nakayama-software/ciren/images/sensor_controller.png

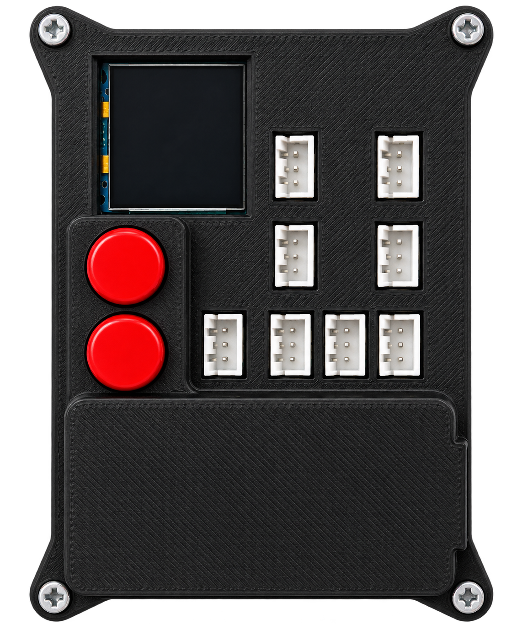
images/sensor_controller.png
