nakayama-software/ciren/frontend/src/assets/forklift.png

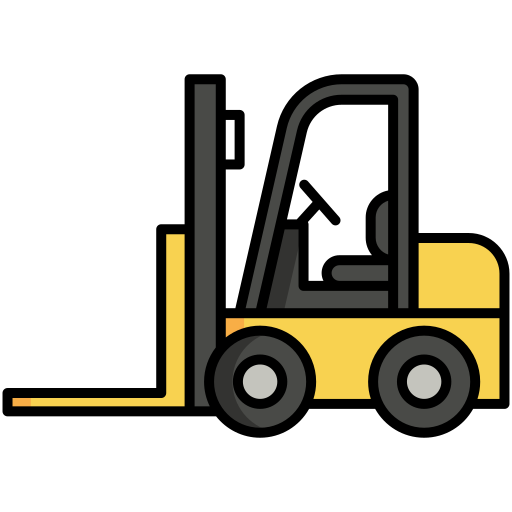
frontend/src/assets/forklift.png
