nakayama-software/ciren/images/summary_data_table_jp.png

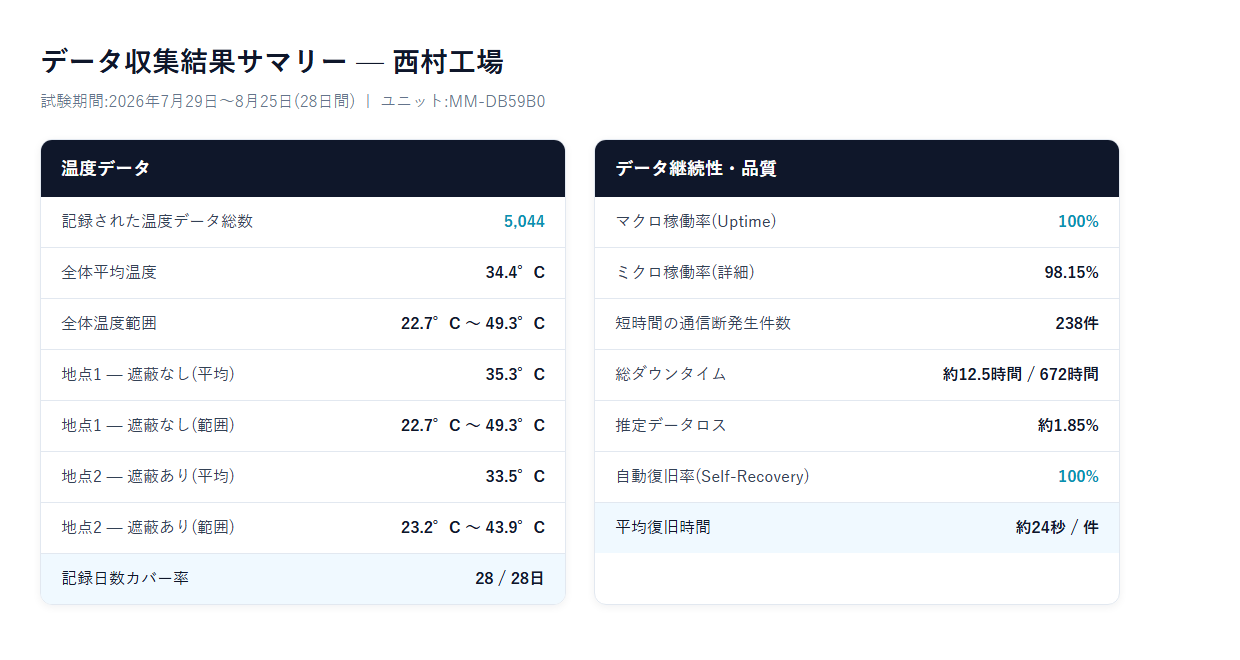
images/summary_data_table_jp.png
