nakayama-software/ciren/CIREN_DOCUMENT/CIREN_MANUAL_BOOK.docx

CIREN

Real-Time IoT Monitoring System

MANUAL BOOK

Version: 1.0

Date: 2026-05-29

Audience: Operators & Daily Users

DOCUMENT CONVENTIONS

[NOTE] | General information worth paying attention to
[TIP] | Helpful suggestion to get the most out of the system
[WARNING] | Action that may cause data loss or system disruption
[REQUIRED] | Step that must not be skipped

CHAPTER 1 — INTRODUCTION

1.1 About This Manual

This manual is the primary operational guide for CIREN. It covers everything you need to install the hardware, access the dashboard, monitor sensor data, configure alerts, export reports, and keep the system running.

This manual is written for operators and daily users. No programming or networking experience is required to follow it.

[NOTE] | For advanced technical details (firmware, protocol, API), refer to the CIREN System Specification document.

1.2 What is CIREN

CIREN is a plug-and-play real-time IoT (Internet of Things) monitoring system. It reads data from physical sensors, transmits that data wirelessly to the cloud, and displays it live on a web-based dashboard — accessible from any browser, anywhere.

Key benefits:

- No complex installation — hardware self-configures on first power-on
- No dedicated IT team needed — designed for non-technical users
- Works even without stable WiFi — built-in LTE-M cellular fallback
- Expandable — add more sensors or locations without replacing hardware

1.3 System Components at a Glance

Component | Description
Sensor Node | Small device with one sensor attached. Plugs into the Sensor Controller via cable.
Sensor Controller | Collects data from up to 8 Sensor Nodes. Sends data wirelessly to the Main Module.
Main Module | The central gateway. Receives data from all controllers and sends it to the cloud via WiFi or LTE-M (cellular) backup.
Dashboard | Web-based control panel. View live readings, set alerts, export data, configure sensors.

1.4 Document Conventions

- Steps are numbered: 1. 2. 3. ...
- Sub-steps are lettered: a. b. c. ...
- File paths and technical values are written in: [square brackets]
- Screen elements (buttons, menus) are written in: "quotes"

CHAPTER 2 — BEFORE YOU START

2.1 What's in the Package

Standard Starter Kit contents:

Qty | Item
1 | Main Module (ESP32-S3 + SIM7080G + TFT display)
1 | Sensor Controller (ESP32)
2 | Sensor Nodes (type depends on order)
2 | UART connection cables (sensor node ↔ controller)
1 | Power supply — Main Module
1 | Power supply — Sensor Controller

[NOTE] | Additional sensor nodes and controllers can be added at any time without replacing existing hardware.

2.2 Requirements

To access the dashboard:

- A modern web browser (Chrome, Firefox, or Edge — latest version)
- Internet access or access to the local network where CIREN is hosted
- A CIREN user account (provided by your system administrator)

To run the hardware:

- Stable power supply for each unit (see power specs in Appendix A)
- WiFi network with internet access, OR a SIM card with LTE-M data plan
- Physical mounting location within sensor range of the controller

2.3 Safety Notes

[WARNING] | Always power off the Main Module before inserting or removing the SIM card. Hot-plugging the SIM can damage the modem.

[WARNING] | Do not expose hardware to rain, condensation, or liquids unless housed in a weatherproof enclosure.

[NOTE] | Operating temperature range: -40°C to +80°C. DHT20 sensor accuracy may degrade above +80°C.

[NOTE] | Use a stable, regulated power supply. Power fluctuations can cause unexpected resets. The system has a built-in hardware watchdog that will auto-restart after a crash (~3 minutes).

CHAPTER 3 — HARDWARE INSTALLATION

Install and commission hardware in this order:

3.1 Power On Main Module | 3.2 Configure WiFi | 3.3 SIM Card & APN | 3.4 Verify Online | 3.5 Power On Controller | 3.6 Verify Controller | 3.7 Connect Sensor Nodes

[NOTE] | Always set up the Main Module and confirm cloud connectivity before adding Sensor Controllers or Nodes. This makes each step verifiable as you go.

3.1 Step 1 — Power On the Main Module

The Main Module is the central gateway. Set it up first.

1. Place the Main Module in its final mounting location.
2. Connect the power supply.
3. The TFT display powers on and shows the boot screen (Device ID, firmware version).
4. Wait ~10 seconds for the module to complete startup.
5. Check the TFT display — it shows one of: "hotspot mode" (go to 3.2), conn mode = "wifi" (go to 3.4), or conn mode = "offline" (go to 3.2).

[NOTE] | The Main Module does not require any sensor hardware to be connected at this stage. It can come online independently.

3.2 Step 2 — Configure WiFi

On first power-on (or after a WiFi reset), the Main Module enters hotspot mode automatically.

6. On your phone or PC, open WiFi settings.
7. Connect to the temporary hotspot created by the Main Module. (Name and password are on the device label.)
8. A configuration page opens automatically. If not, navigate to: [192.168.4.1]
9. Enter your WiFi network name (SSID) and password.
10. Click "Save" or "Connect".
11. The Main Module reboots and connects to your WiFi.
12. TFT display changes to: conn mode = "wifi".

[NOTE] | If setup fails (wrong password, out of range), the module retries. Power cycle to re-enter hotspot mode.

[TIP] | If the facility has a dedicated IoT VLAN, use that network for better isolation.

[TIP] | If you will rely entirely on LTE-M (no WiFi), skip this step and proceed directly to Step 3.

3.3 Step 3 — Insert SIM Card & Configure APN (Optional — LTE-M Fallback)

The SIM card enables automatic connectivity when WiFi is unavailable. Configure APN settings before verifying connectivity, so both connection paths are ready.

[REQUIRED] | Power off the Main Module completely before inserting the SIM card.

A. Insert SIM Card

13. Power off the Main Module and disconnect power.
14. Locate the SIM card slot on the SIM7080G modem (side of the Main Module enclosure).
15. Insert a nano SIM card with an active LTE-M (Cat-M1) data plan. Recommended: Soracom Air plan-D (~¥330/month, includes 300MB). Any LTE-M compatible SIM will work.
16. Reconnect power and power on the Main Module.

B. Configure APN Settings

17. Connect to the Main Module hotspot (or existing WiFi) and open the config page at: [192.168.4.1]
18. Navigate to the "SIM / Cellular" settings section.
19. Enter the APN details for your SIM provider (see table below).
20. Click "Save". The module reboots.
21. The module tries WiFi first. If WiFi is unavailable, it switches to LTE-M automatically. TFT shows: conn mode = "sim".

Provider | APN | Username | Password
Soracom Air | soracom.io | sora | sora
IIJmio (LTE-M) | iijmio.jp | mio@iij | iij
Other providers | (see SIM provider documentation) | — | —

[NOTE] | CIREN sensor data is very lightweight (well under 300MB/month even with many sensors at high update rates).

[TIP] | Even if WiFi is available, installing a SIM card is recommended as insurance against network outages.

[NOTE] | If the APN is incorrect, the modem will fail to register on the network. The TFT will show conn mode = "sim" but the device will appear offline on the dashboard. Double-check APN with your SIM provider if this occurs.

3.4 Step 4 — Verify Main Module is Online

Confirm the Main Module is connected and visible on the dashboard before adding any Sensor Controllers.

22. Open the CIREN dashboard in a browser.
23. Log in with your account credentials.
24. The device should appear in the Device List within ~30 seconds.
25. The status indicator should show "Online".
26. Check the connection mode badge — "WiFi" or "LTE-M".

[NOTE] | If the device does not appear after 60 seconds, refer to Chapter 10 — Troubleshooting, Section 10.1.

[REQUIRED] | Do not proceed to Step 5 until the Main Module shows "Online" on the dashboard.

3.5 Step 5 — Power On the Sensor Controller

Once the Main Module is confirmed online, power on the Sensor Controller.

27. Place the Sensor Controller within wireless range of the Main Module. Recommended: within 30–50 meters in industrial environments. Walls and metal reduce range significantly.
28. Connect the Sensor Controller to its power supply (3.3V regulated / USB).
29. The controller starts automatically — no buttons to press.
30. It begins scanning for the Main Module via ESP-NOW (2.4 GHz).

[NOTE] | At this stage, sensor nodes do not need to be connected yet. The controller will pair with the Main Module first.

[TIP] | During initial setup, place the Sensor Controller physically close to the Main Module to ensure reliable first pairing. It can be moved to its final location after pairing is confirmed.

3.6 Step 6 — Verify Sensor Controller Detected

Confirm the Sensor Controller is paired with the Main Module before connecting any Sensor Nodes.

On the TFT display (Main Module):

31. Wait for Page 4 — Controller List to appear (display cycles automatically).
32. Confirm the controller's MAC address or ID appears in the list.
33. The "last received" timestamp should be updating within the last few seconds.

On the Dashboard:

34. Open Device Detail for the Main Module device.
35. A new Sensor Controller card should appear.
36. All 8 port slots will show as empty/inactive — this is expected.

[NOTE] | If the controller does not appear within ~30 seconds, check distance and obstacles. Move closer and power cycle the controller.

[REQUIRED] | Do not connect Sensor Nodes until the controller is visible on the dashboard.

3.7 Step 7 — Connect & Verify Sensor Nodes

Connect Sensor Nodes one at a time and verify each one before continuing. This makes troubleshooting easier if a node has a problem.

For each Sensor Node:

37. Identify the target port number on the Sensor Controller (labeled 1–8).
38. Connect the Sensor Node cable to the port. Match wire colors: VCC (red) → VCC, GND (black) → GND, TX → RX, RX → TX.
39. Secure the cable connector firmly.
40. Wait ~5–10 seconds.
41. On the dashboard (Device Detail), the corresponding port card should become active and show: sensor type (auto-detected) and a live reading value.
42. Confirm the reading looks reasonable for the sensor type and location.
43. Assign a label to the port (see Section 6.1). E.g., "Port 1 — Cold Room East".
44. Repeat for each remaining Sensor Node.

[NOTE] | Maximum cable length between node and controller: ~10 meters. Use shorter cables where possible.

[NOTE] | Sensor type is detected automatically. No manual type selection is needed.

[TIP] | Label each port immediately at installation, before moving to the next node. Labels carry through to exported data files.

[WARNING] | If a port does not activate within 30 seconds, check the cable connection and wire color matching. Do not proceed to the next node until the current one is confirmed active.

CHAPTER 4 — DASHBOARD ORIENTATION

4.1 Logging In

45. Open your browser and navigate to the CIREN dashboard URL. (Provided by your system administrator.)
46. Enter your username and password.
47. Click "Login".

[NOTE] | If you forget your password, contact your system administrator. There is no self-service password reset.

4.2 Dashboard Layout Overview

Level | Name | Description
Level 1 | Device List | The home page. Shows all devices registered to your account. Each card displays device name/ID, Online/Offline status, connection mode, and last seen timestamp.
Level 2 | Device Detail | Opened by clicking a device. Shows all Sensor Controllers connected to that device. Each controller lists its sensor ports (1–8) as cards.
Level 3 | Sensor Card | Each port shows a Sensor Card with: current live reading, port label, upload interval badge, and threshold alert indicator.

4.3 Device List Page

What you see:

- All registered devices in a list or grid
- Green dot = Online | Grey dot = Offline
- "WiFi" or "LTE-M" badge showing active connection type
- Last seen time (e.g., "2 seconds ago" or "Last seen: 14:32:05")

Actions available:

- Click a device → opens Device Detail
- The list updates automatically in real time via WebSocket

4.4 Device Detail Page

What you see:

- All Sensor Controllers linked to this device
- Each controller shows 8 port slots (occupied or empty)
- Each occupied port shows a Sensor Card with live data

[NOTE] | Empty ports (no sensor connected) show as inactive/greyed out. They become active automatically when a sensor node is plugged in.

4.5 Sensor Card Explained

Element | Description
Port Label | Custom name you assign (e.g., "Cold Room 1"). Default: "Port 1", "Port 2", etc.
Interval Badge | Upload frequency (e.g., "500ms"). Click to change.
Live Reading | The most recent sensor value with its unit.
Sensor Type | Detected automatically (e.g., "Temperature", "Vibration").
Threshold Indicator | Shows a warning if the value is out of your set range.

4.6 Status Indicators

Indicator | Meaning
● Green (device) | Online — data being received in real time
● Grey (device) | Offline — no data received recently
[WiFi] | Main Module connected via your local WiFi network
[LTE-M] | Main Module connected via SIM cellular (WiFi unavailable)
[500ms] badge | Sensor uploads a new reading every 500 milliseconds
[Pending] badge | A new interval was set but not yet received by the controller
[Delivered] badge | Interval configuration confirmed by the controller

[NOTE] | When a device goes offline, the last known sensor values remain visible on all Sensor Cards. A timestamp shows when data was last received.

CHAPTER 5 — DAILY OPERATIONS

5.1 Monitoring Live Sensor Data

Live data updates automatically — you do not need to refresh the browser.

48. Log in to the dashboard.
49. Click a device from the Device List.
50. View the Sensor Cards on the Device Detail page.
51. Each card updates its reading in real time as new data arrives.

[TIP] | Keep the dashboard open on a dedicated monitor at your workstation or control room for continuous visibility.

5.2 What the Readings Mean

Sensor / Reading | Unit | Notes
Temperature | °C | Ambient air temperature. Normal room: ~18°C–25°C. Cold storage: 0°C–8°C.
Humidity | % RH | Relative Humidity. Comfortable indoor: 40%–60% RH. 100% = condensation risk.
Acceleration X/Y/Z | m/s² | Vibration and movement. Near-zero = at rest. Spikes = abnormal vibration.
Gyroscope X/Y/Z | °/s | Rotational speed. Useful for detecting tilt, rotation, or angular movement.
Pitch / Roll / Yaw | ° | Euler angles from IMU. Pitch = forward/backward. Roll = left/right. Yaw = rotation.

5.3 Checking Device Connection Status

52. On the Device List page, check the status indicator for each device.
53. If a device shows "Offline", check the Main Module at the physical site: Is it powered on? What does the TFT display show? Is WiFi available or the SIM card active?
54. Refer to Chapter 10 — Troubleshooting for specific scenarios.

5.4 Offline Device — What to Expect

When a device loses connection:

- The device status changes to "Offline" on the Device List.
- All Sensor Cards continue to display the last known values.
- A "Last seen" timestamp shows when data was last received.
- Data is NOT lost — readings taken while offline are stored in the device's local buffer and re-published when connection is restored.

[NOTE] | If the device has been offline for an extended period, the last-seen values may be significantly outdated. Check the timestamp before acting on the displayed reading.

CHAPTER 6 — SENSOR CONFIGURATION

6.1 Assigning Labels to Sensor Ports

Labels make it easy to identify sensors on the dashboard and in exports. Example: rename "Port 3" to "Freezer Room — East Wall".

55. Open the Device Detail page and find the Sensor Card you want to label.
56. Click the label / edit icon next to the current port name.
57. Type a descriptive name.
58. Click "Save".
59. The new label appears on the card and in all exported data files.

[TIP] | Use location + measurement: e.g., "Motor A — Vibration"

6.2 Setting Upload Intervals

The upload interval controls how often a sensor node sends a new reading. A shorter interval = more frequent data = higher data usage.

Sensor Type | Default Interval | Recommended Minimum
Temperature / Humidity | 500ms (2 readings/sec) | 500ms
IMU / Vibration | 200ms (5 readings/sec) | 200ms

Steps to change the interval:

60. Click the interval badge on the Sensor Card (e.g., "[500ms]").
61. A dialog opens — enter the new interval in milliseconds. Example: 1000 = 1 second, 5000 = 5 seconds, 60000 = 1 minute.
62. Click "Save".
63. The badge changes to "[Pending]" while the setting is being delivered.
64. When the controller confirms receipt, it changes to "[Delivered]".

[NOTE] | The interval is saved on the controller's non-volatile memory. It is retained after a power cut and does not need to be re-entered after a reboot.

[TIP] | For non-critical monitoring (e.g., room temperature), set a longer interval (5000ms–60000ms) to reduce data usage and storage.

6.3 Hot-Swapping a Sensor Node

CIREN supports hot-swapping — you can replace a sensor node on a port without restarting the system.

65. Unplug the sensor node cable from the controller port.
66. Plug in the new sensor node to the same port.
67. The controller detects the new sensor type automatically within ~5 seconds.
68. The Sensor Card on the dashboard updates to show the new sensor type and reading.

[NOTE] | When a sensor type changes on a port, the upload interval resets to the default for the new sensor type. Re-configure the interval if needed (see Section 6.2).

[WARNING] | Do not hot-swap while the controller is transmitting a config update (interval badge shows "Pending"). Wait for "Delivered" or "Failed" before swapping.

CHAPTER 7 — ALERTS & THRESHOLDS

7.1 Setting a Threshold

Thresholds define acceptable value ranges for a sensor. The dashboard shows a visual alert when a reading falls outside the range.

69. Open the Sensor Card for the target sensor.
70. Click the threshold icon or button (bell / alert icon).
71. A dialog opens with two fields: Minimum (alert if value falls BELOW this) and Maximum (alert if value rises ABOVE this). You can set one or both.
72. Click "Save".

Example — Cold Room temperature:

- Minimum: 0°C (alert if it drops below freezing)
- Maximum: 8°C (alert if it rises too high)

7.2 Understanding Threshold Alerts

When a sensor reading crosses a threshold:

- The Sensor Card shows a visual warning indicator (color change / icon).
- The alert is visible in real time as long as the browser is open.

[NOTE] | CIREN dashboard alerts are visual only (on-screen). There is no email or SMS notification in the current version. Keep the dashboard open on a monitor for continuous alerting.

[TIP] | For attended monitoring environments, assign a team member to watch the dashboard during critical operating hours.

7.3 Editing or Removing a Threshold

To edit:

73. Click the threshold icon on the Sensor Card.
74. Change the minimum and/or maximum values.
75. Click "Save".

To remove:

76. Click the threshold icon on the Sensor Card.
77. Clear both the minimum and maximum fields.
78. Click "Save".
79. The threshold alert is removed from that sensor card.

CHAPTER 8 — HISTORICAL DATA & EXPORT

8.1 Viewing Sensor History Chart

80. Open the Sensor Card for the target sensor.
81. Click the "History" button or chart icon.
82. A modal opens with a line chart of historical readings.
83. The chart loads automatically for a default time range (e.g., last hour).
84. Use the time range selector to zoom in or out (see Section 8.2).

8.2 Filtering by Time Range

In the History modal:

85. Use the time range controls to set a "From" and "To" date/time.
86. Click "Apply" or "Load" to refresh the chart.

[NOTE] | Historical data is stored for 30 days. Readings older than 30 days are automatically deleted.

[TIP] | For compliance reporting, export data regularly (see Section 8.3) rather than relying on the 30-day retention window.

8.3 Exporting Data (CSV / JSON)

Export sensor readings to a file on your computer for reporting, archiving, or further analysis in Excel or other tools.

87. Open the Sensor Card and click "History" or the "Export" button.
88. In the export dialog, select: Format (CSV or JSON), Device, Sensor, From date/time, To date/time.
89. Click "Download".
90. The file downloads to your computer automatically.

[TIP] | CSV format is recommended for most users. Open it directly in Microsoft Excel or Google Sheets for charts and analysis.

8.4 Using Exported Data

CSV file structure:

timestamp, device_id, ctrl_id, port_num, sensor_type, value

Example row:

2026-05-29T08:32:15.000Z, ciren-001, 1, 3, temperature, 22.4

[TIP] | In Excel, use "Insert Chart" with the timestamp and value columns to create a visual trend chart for reports.

CHAPTER 9 — MAINTENANCE

9.1 Routine Checks (Recommended: Weekly)

Hardware:

☐ All sensor node cables are firmly connected to the controller

☐ All units have stable power (check power LEDs)

☐ Main Module TFT display shows correct conn mode (wifi/sim)

☐ Main Module is online on the dashboard

Dashboard:

☐ All expected devices show "Online" status

☐ Sensor readings are updating in real time (not frozen)

☐ No unexpected threshold alerts are active

9.2 Hardware Care & Placement Tips

Main Module:

- Mount in a dry, ventilated location — avoid direct sunlight
- Keep away from strong electromagnetic sources (motors, inverters)
- Ensure WiFi antenna has clear line of sight to the router

Sensor Controller:

- Mount within 30–50m of the Main Module in industrial environments
- Avoid placing behind thick concrete walls or large metal structures
- Keep ventilated — operating temperature up to +85°C

Sensor Nodes:

- Mount sensors in the location being measured, not the controller
- DHT20 (temperature/humidity): avoid condensing environments; allow airflow around the sensor
- MPU6050 (vibration): mount firmly on the surface being measured; loose mounting causes noise

Cables:

- Secure UART cables to prevent vibration-induced disconnection
- Maximum cable length: ~10 meters (shorter is better)
- Avoid routing cables near high-voltage power lines

9.3 Updating WiFi Credentials

If your WiFi network name or password changes:

91. Power cycle the Main Module (turn off, wait 5 seconds, turn on).
92. While powered off, hold the [WiFi Reset] button for 3 seconds to clear stored credentials and re-enter hotspot mode.
93. The TFT display shows the module is in hotspot/setup mode.
94. Follow the WiFi setup steps in Section 3.2.

9.4 SIM Card Management

Checking data usage:

- Log in to your SIM provider's portal (e.g., Soracom console).
- CIREN typically uses well under 300MB/month per device.

Replacing a SIM card:

95. Power off the Main Module completely.
96. Remove the old SIM and insert the new one.
97. Power on — the modem registers to the new SIM automatically.

If LTE-M stops working:

- Check SIM card is seated correctly (remove and re-insert)
- Confirm data plan is still active (check provider portal)
- Confirm LTE-M coverage at your location (check carrier coverage map)

CHAPTER 10 — TROUBLESHOOTING

10.1 Device Shows Offline on Dashboard

Symptoms: Device status = grey "Offline", last seen time is old.

Check | Action
a) Main Module powered on? | Check power LED. If off: check power cable and supply.
b) TFT display reading? | "wifi" = connected to WiFi but not server — check internet. "sim" = LTE-M active — check SIM plan. Blank/error = check power supply.
c) WiFi credentials changed? | Re-configure WiFi (see Section 9.3).
d) Server running? | Contact your system administrator.
e) Hardware watchdog? | Module auto-restarts within ~3 minutes after a crash. Wait and check again before taking further action.

10.2 No Sensor Data on a Port

Symptoms: Sensor Card on dashboard shows no reading or is inactive.

Check | Action
a) Cable plugged into correct port? | Verify the physical connection at the controller.
b) Sensor node powered? | Check sensor node power LED. Try disconnecting and reconnecting the cable.
c) Controller detecting the sensor? | Auto-detection takes up to 10 seconds after plug-in.
d) Controller in range? | Move closer or remove obstructions. Keep within 30–50m in industrial environments.
e) Recently hot-swapped? | Sensor type resets on swap — wait for auto-detection.

10.3 Upload Interval Stuck on "Pending"

Symptoms: Interval badge shows "Pending" for more than 2 minutes.

Check | Action
a) Controller online? | If the device itself is offline, resolve that first (see 10.1).
b) Controller rebooted? | Config is automatically re-sent within ~10 seconds of reboot. Wait briefly and check again.
c) Re-send manually? | Open the interval setting dialog again, re-enter the value, and click Save to re-trigger delivery.

10.4 Data Export Returns Empty

Symptoms: Exported file has no rows (CSV) or empty array (JSON).

Check | Action
a) Time range correct? | Open the History chart for the same sensor and time range. If chart is also empty, no data exists for that period.
b) Correct device/sensor? | Confirm the correct device ID and port number are selected in the export dialog.
c) Data retention limit? | Data older than 30 days is automatically deleted. Older data must have been exported previously.

10.5 Main Module Won't Connect to WiFi

Cause | Fix
Wrong password | Re-enter WiFi credentials (see Section 9.3).
Network out of range | Move the Main Module closer to the router, or use a WiFi repeater/extender.
Network uses 5 GHz only | CIREN supports 2.4 GHz only. Ensure your router has a 2.4 GHz band enabled.
Captive portal network | CIREN cannot authenticate through captive portals. Use a standard password-protected WiFi network.
WiFi cannot be resolved | Insert a SIM card and use LTE-M as the primary connection (see Section 3.3).

10.6 When to Contact Support

Contact your system administrator or CIREN support if:

- The Main Module TFT display shows a persistent error code
- A device has been offline for more than 24 hours with no clear cause
- Sensor readings appear incorrect or unrealistic after checking cables
- You need to add new sensor nodes, controllers, or devices
- You need a new user account or password reset

When contacting support, have the following ready:

- Device ID (shown on the dashboard and on the Main Module label)
- Description of the problem and when it started
- What you have already tried (from the steps above)
- Any error messages or codes shown on the TFT display

APPENDIX A — SENSOR QUICK REFERENCE

DHT20 — Temperature & Humidity

Measurement | Range | Accuracy | Default Interval
Temperature | -40°C to +80°C | ±0.5°C | 500ms
Humidity (RH) | 0% to 100% RH | ±3% RH | 500ms

[NOTE] | Avoid condensing environments for long-term accuracy.

MPU6050 — Vibration / IMU (Accelerometer + Gyroscope)

Measurement | Range | Unit | Default Interval
Acceleration | ±2g to ±16g | m/s² | 200ms
Gyroscope | ±250 to ±2000°/s | °/s | 200ms
Pitch/Roll/Yaw | 0° to 360° | ° | 200ms

[NOTE] | Mount firmly on the surface being measured. Avoid strong magnetic fields.

APPENDIX B — MAIN MODULE TFT DISPLAY PAGES

The Main Module has a 2.4" TFT display that cycles through 6 status pages.

Page | Name | Information Shown
1 | Identity | Device ID, firmware version, uptime
2 | Connectivity | conn mode (wifi / sim / offline), IP address or signal strength
3 | MQTT Status | Connection state, broker address, last publish timestamp
4 | Controller List | Number of active controllers, last received data from each
5 | System Health | Free heap memory, CPU load, watchdog status
6 | SIM / Cellular Status | Carrier name, signal quality, data session status (shown only if SIM inserted)

APPENDIX C — GLOSSARY

Term | Meaning
APN | Access Point Name — the network address setting required by a SIM card to connect to the mobile data network.
Dashboard | The web-based control panel for CIREN, accessible from any browser.
Device | A complete CIREN installation at one location, identified by a unique Device ID.
ESP-NOW | The short-range wireless protocol used internally between Sensor Controllers and the Main Module. No internet required — works like local radio.
Euler Angles | Pitch, Roll, and Yaw — three angles that describe the orientation of an object in 3D space.
Firmware | The embedded software running inside the hardware components (not user-editable in normal operation).
Hot-swap | Replacing a sensor node while the system is running, without powering off or restarting.
IMU | Inertial Measurement Unit — a sensor that measures acceleration and rotation. Used for vibration monitoring and orientation tracking.
LTE-M / Cat-M1 | A low-power cellular standard for IoT devices. Works on mobile networks (requires a SIM card).
Main Module | The central gateway device. Receives data from all Sensor Controllers and sends it to the cloud.
MQTT | The lightweight messaging protocol used by CIREN to send sensor data to the cloud backend.
NVS | Non-Volatile Storage — memory that retains data after a power cut (used to store interval configs).
Relative Humidity | % RH — the amount of moisture in the air relative to the maximum it can hold at that temperature. 0% = dry, 100% = saturated.
Sensor Controller | The device that collects data from up to 8 Sensor Nodes and forwards it wirelessly to the Main Module.
Sensor Node | The smallest unit in the system. One sensor per node. Plugs into the Sensor Controller via cable.
Threshold | A user-defined min/max range for a sensor. The dashboard alerts visually when the range is exceeded.
Upload Interval | How often a Sensor Node sends a new reading. Set in milliseconds (e.g., 500ms = twice per second).
WebSocket | The real-time connection between the backend server and your browser — enables live dashboard updates without page refresh.
WiFi Hotspot | A temporary WiFi network created by the Main Module during first-time WiFi setup.

CIREN Manual Book v1.0 | 2026-05-29 | Confidential
