nakayama-software/ciren/(commit log)

2025-10-27 update sensor controller
2025-10-28 solving sensor controller
2025-10-28 update sensor controller and sensor main
2025-10-30 update RX pin
2025-11-10 make sensor controller hardcoded mac
2026-01-16 update sensor controller and sensor_node
2026-01-23 update sensor node
2026-03-12 update auth flow
2026-03-12 handle host port in sensor controller
2026-03-31 add new system: server, dashboard-frontend, IoT firmware; fix gitignore for node_modules
    [ciren_frame.h]
2026-04-01 feat: SIM fallback, equal-height sensor cards, 30s visibility filter, new sensor components
    Firmware (main_module):
    - Add GPS polling via SIM7600 modem (_sim_update_gps) with stale detection
    - Add WiFi→SIM auto-fallback: if WiFi fails, switch to SIM MQTT; probe WiFi in background and restore when available
    - Fix: WiFi MQTT disconnect event no longer clears is_connected while SIM mode is active
    Dashboard (new dashboard-frontend):
    - Equal-height sensor grid cards using h-full flex flex-col + flex-1 pattern
    - Filter: controllers not seen >30s are hidden; nodes not seen >30s are hidden per controller
    - Add individual sensor card components: Temperature, Voltage, Current, Ultrasonic, LightInte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
2026-04-01 feat: replace OLED with SPI TFT LCD 2.4" ILI9341 320x240
    - Remove Adafruit_SSD1306; replace with Adafruit_ILI9341 (VSPI: SCK=18, MOSI=23, MISO=19)
    - Add PIN_TFT_CS=5, PIN_TFT_DC=2, PIN_TFT_RST=4 to ciren_config
    - Move PIN_BTN from 18 (SPI SCK conflict) to 0 (BOOT button)
    - Redesign all 6 pages with full color, professional layout (320x240 landscape):
    - Page 0 Gateway: mode/status badges, RSSI signal bars + bar, buffer bar, uptime, MAC
    - Page 1 WiFi: SSID, IP, signal bars, channel
    - Page 2 SIM: modem badge, operator, signal bars, GPRS status
    - Page 3 GPS: fix badge, lat/lon at 2x font, alt, fix age
    - Page 4 Settings: portal AP/QR info or connected SSID + hold hint
    - Page 5 SIM Con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
2026-04-01 fix: update TFT SPI pins for ESP32-S3 (no pin 23)
    - Add explicit PIN_TFT_SCK/MOSI/MISO defines (12/11/13)
    - Update CS/DC/RST to safe ESP32-S3 GPIOs (10/9/8)
    - Call SPI.begin(SCK, MISO, MOSI) before tft.begin() so hardware SPI
    uses the correct pins (ESP32-S3 default SPI pins differ from classic ESP32)
    - Keep hardware SPI constructor (3-arg) for full 40MHz throughput
    Wiring: SCK=12, MOSI=11, MISO=13, CS=10, DC=9, RST=8, BTN=0
2026-04-01 fix: button press missed due to 200ms polling interval
    Poll button every 20ms (50Hz) inside task loop, redraw TFT only when
    TFT_REFRESH_MS (200ms) has elapsed. Previously vTaskDelay(200ms) meant
    a short press (<200ms) was never seen by digitalRead.
2026-04-01 fix: reinit TFT in task_oled (Core 0) to fix display not updating
    btn_oled_init() runs in setup()/Core 1; task_oled runs on Core 0.
    Some Adafruit + ESP32-S3 combinations require SPI.begin() + tft.begin()
    to be called from the same core that will use the SPI bus.
    Fix: reinit SPI+TFT at start of task_oled before main loop, then
    force page_dirty=true for a clean first redraw.
    Also add 5-tick Serial debug to confirm tft_draw() is being called.
2026-04-02 add production env config and fix deploy setup
    - add new dashboard-frontend/.env.production (API + WS URLs for VPS 118.22.31.249)
    - add new_Server/.env.production (MongoDB + MQTT pointing to 118.22.31.254)
    - update backend index.js to load .env.production when NODE_ENV=production
    - fix SIM manager: GPS/signal always updates independent of GPRS state
    - fix SIM manager: state_set_connected called on GPRS connect/drop
    - fix main module setup: all tasks start even when no WiFi credentials
    - fix WiFi reset flow: portal auto-starts on boot, hold-button resets from any page
    - add dual chart to HumTempCard, fix ghost sensor and active node count
    - add LabelManager and MultiSensorView components
    - ad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
2026-04-09 feat: major system update — firmware fixes, backend hardening, frontend improvements
    - Hybrid MAC-based device ID, persisted in NVS, overridable via portal
    - Dynamic MQTT topics built at runtime via state_build_topics()
    - APN SIM card configurable via web portal (thread-safe with mutex)
    - Dynamic portal password from MAC address
    - hello_sent reset on disconnect to ensure re-send on reconnect
    - RSSI fix for SIM mode, queue timeout fix
    Firmware (sensor_controller):
    - Fix RX_P4 GPIO14 → GPIO32 (was conflicting with BUTTON_INC)
    - PORT_ACTIVE set to 8 for full plug-and-play support
    Backend:
    - WebSocket JWT auth + ping/keepalive
    - Rate limiting 50 msg/s per device in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
    [sensor_controller.ino]
2026-04-09 docs: add .claude/context.md for cross-device session continuity
2026-04-09 fix: replace DEVICE_ID macro with sys_state.device_id at all remaining sites
    DEVICE_ID static macro was removed in favor of runtime MAC-based ID.
    Updated 4 remaining references in task_btn_oled and main_module setup().
2026-04-10 feat: configurable per-sensor-node upload interval
    Sensor controller:
    - Per-port throttle buffer: latest reading per (port, stype),
    forwarded at user-configured interval (default 500ms, 200ms for IMU)
    - FTYPE_CONFIG/CONFIG_ACK: receive interval via ESP-NOW, persist to
    Preferences, send ACK back to main module
    - Sensor swap detection: auto-reset interval and clear buf on stype change
    Main module:
    - task_node_config_014424.h: NVS storage (Preferences "nodecfg"),
    FreeRTOS retry task (600ms timeout, 3 retries), mutex-protected table
    - WiFi + SIM MQTT: parse set_node_interval action → nc_set()
    - ESP-NOW CONFIG_ACK → nc_on_ack(), CTRL HELLO → nc_resync_ctrl()
    - SIM MQTT: subscribe top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
    [sensor_controller.ino]
2026-04-26 docs: comprehensive documentation update + repo restructuring
    - CLAUDE.md: full rewrite in English with hardware specs, FreeRTOS task
    table, MQTT topics, frame protocol, per-node interval system, and
    known constraints/gotchas for AI context
    - readme.md (root): full rewrite in English with system architecture,
    hardware BOM, protocol reference, backend/frontend stack, deploy guide
    - backend/readme.md: stack, source layout, API endpoints, MQTT topics,
    env vars
    - frontend/readme.md: stack, component inventory, feature list
    - IOT System/new_main_module/readme.md: variant table, pinout, FreeRTOS
    task list, display pages, flashing instructions
    - IOT System/sensor_controller/readme.md: ESP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
2026-04-30 ui: slim down header nav — icon-only theme/devices, shorter lang labels
    - Theme toggle: icon-only (remove 'ダーク'/'Light' text label)
    - Language switcher: remove redundant Globe icon, '日本語' → 'JP'
    - Devices button: icon-only
    - WS status text hidden below lg breakpoint
    - Reduce gap from gap-3 to gap-2
2026-04-30 fix: improve MAC address text visibility on TFT display
    'MAC:' label → C_GRAY, MAC value → C_WHITE.
    C_ACCENT (cyan) at textSize(1) was too faint on black background.
2026-04-30 ui: clean up DeviceManagementPage header subtitle and lang switch
    - Remove username from subtitle (was 'username · IoTメインモジュールを管理')
    - LangSwitch: remove Globe icon, shorten '日本語' → 'JP' (consistent with App.jsx)
    - Remove unused Globe import
2026-04-30 ux: remove Dashboard button from header, device card opens specific device
    - DeviceManagementPage: remove Dashboard button from desktop nav and
    mobile menu — user selects device by clicking its card instead
    - Device card chevron now calls onGoToDashboard(id), passing the device ID
    - App.jsx handleGoToDashboard(deviceId): immediately selects the chosen
    device before switching to dashboard page
    - Fix: remove Globe icon from mobile menu language section (Globe import
    was removed in previous commit but still referenced in mobile menu)
    - Theme toggle: icon-only, consistent with App.jsx header style
    - Remove unused LayoutDashboard import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
2026-05-01 feat: add onboarding tour with driver.js for first-time users
    - Auto-starts on first dashboard visit (localStorage flag prevents repeat)
    - Highlights: controller cards, main module status, WS indicator, theme, language, device management
    - Bilingual (JP/EN) matching the app language setting
    - Help (?) button in header to replay the tour at any time
    - Dark-themed popover overrides to match CIREN's UI
2026-05-01 feat: extend onboarding tour to cover login → devices → dashboard flow
    - Login page: 5-step tour (welcome → login btn → username → password → submit)
    clicking Next at step 1 programmatically opens the login form
    - Device management: 3-step tour (welcome → add device → device list)
    - Dashboard: existing 6-step tour unchanged
    - Tours chain via localStorage stage key (null → devices → dashboard → done)
    - Help (?) button on dashboard restarts only the dashboard portion
    - Backward-compatible with old ciren-tour-done key
2026-05-01 fix: start onboarding from register, not login
    Flow: login-landing → register form → login form → devices → dashboard
    - login-landing: welcome + highlight Register button
    - register: 5-step tour of the register form
    - login-form: auto-shows form + 4-step tour after registration
    - LoginPage detects stage (null vs login-form) and shows the right tour
    - RegisterPage: added data-tour attrs + OnboardingTour render
2026-05-14 feat: add demo WebSocket auth bypass for exhibition
    Allow connection with ?demo=ciren-demo query param without JWT token.
    Used by the exhibition demo page to receive sensor data broadcasts.
2026-05-19 feat: exhibition demo, firmware tuning, business documents, and backend utilities
    Demo (demo/index.html):
    - Replace fake scenario loop with real-time WebSocket sensor handler
    - Filter display to DEMO_DEVICE_ID (MM-17BCDC) only
    - enterDemo() now gated behind device_id filter — other devices don't trigger video
    - Persistent audio unmute on any click/touch (fix { once: true } issue)
    - Time-based lerp (K=50) for smooth 3D IMU visualization
    - IMU card: add status dot + setDot call
    - Add demo_simulator.js for offline exhibition rehearsal
    Firmware:
    - sensor_controller: INTERVAL_IMU_MS 100→50ms, ENV/OTHER 500ms
    - sensor_controller: NVS cap >500ms on boot; FTYPE_CONFIG cap >60000ms
    - node_dht20: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
    [ciren_frame.h, main_module_sim7080g.ino, node_dht20.ino, node_mpu6050.ino, node_rs485.ino]
2026-05-25 feat: device/controller labeling, offline last-data display, table pagination
    - Add AliasInlineEdit to Main Module Status card and controller overview cards
    so users can set custom labels for both the main module and each controller
    - Show alias in header subtitle and device tabs when set
    - Fix controller cards hidden after 24h offline: only hide if truly unregistered
    (no nodes in DB and never seen); show all controllers with registered nodes
    - Show registered node count on offline controller cards instead of 0
    - Extend lastSeenLabel to include days (d ago)
    - Pass isOnline to ControllerDetailView and show amber offline banner
    ("Device offline — showing last known data") when device i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
2026-05-25 feat: centralize config — backend + frontend both read from root .config
    - Backend: load dotenv from root .config instead of backend/.env
    (reads BACKEND_PORT with PORT fallback)
    - Frontend: vite.config.js parses root .config and injects
    FRONTEND_API_BASE → VITE_API_BASE and FRONTEND_WS_URL → VITE_WS_URL
    via define; server host/port/proxy also driven from .config
    - Add .config to main branch (was previously only on release)
2026-05-28 chore: remove Claude files from tracking, fix duplicate mongoose index
    - Add CLAUDE.md to .gitignore and untrack .claude/ + CLAUDE.md
    - Remove duplicate server_ts index in SensorReading schema (index:true
    conflicted with TTL schema.index)
2026-05-29 docs: add CIREN Manual Book v1.0
    Operational user guide for non-technical operators. Covers hardware
    installation, dashboard orientation, daily monitoring, sensor config,
    alerts, historical data export, maintenance, and troubleshooting.
    Includes sensor quick reference, TFT display page reference, and
    glossary of 18 terms.
2026-06-08 fix: drop ESP-NOW frames with null ctrl_id in MQTT handler
    Frames with missing ctrl_id were being upserted into the SensorNode
    collection, creating ghost "controller null" entries in the dashboard.
    Added an early return guard in handleSensorData to reject such frames
    and log a warning instead.
2026-06-11 fix: replace Arduino String with static char buffers in SIM AT layer
    All heap-allocating String objects in _sim_sendAT, _sim_atReply,
    _smq_drain, _smq_pub, and _smq_process_urcs replaced with fixed-size
    static/stack char arrays. Eliminates heap fragmentation from continuous
    char-by-char String growth in the SIM MQTT polling loop (every 100ms),
    which was causing intermittent crashes after 1-3 hours of operation.
    [task_mqtt_sim.h, task_sim_manager.h]
2026-06-11 feat: remote reboot via MQTT config topic
    Publish {"action":"reboot"} to ciren/config/{device_id} to trigger
    esp_restart() remotely. Handled in both WiFi (task_publish) and SIM
    (task_mqtt_sim) MQTT paths.
    [task_mqtt_sim.h, task_publish.h]
2026-06-11 fix: clean up null/zero ctrl_id SensorNodes on startup, strengthen guard
    Stale SensorNode documents with ctrl_id=null (created before the 54a7387
    guard was added) were never deleted from MongoDB, causing 'Controller null'
    to keep appearing in the dashboard for MM-FE0FAC.
    - Add _cleanupNullCtrlIds(): deletes SensorNode docs where ctrl_id is null
    or 0 on every backend startup
    - Strengthen inbound guard from `ctrl_id == null` to also reject ctrl_id===0
    (sensor controllers always send 1-9; 0 is invalid)
2026-06-11 fix: AT+SMDISC cleanup before SMCONN, suppress null-handle watchdog warning
    SMCONN fails after ESP32 reboot when modem retains stale MQTT session
    (modem keeps power across ESP32 reflash/restart). AT+SMDISC clears the
    stale session; ERROR response (if already disconnected) is intentionally
    ignored.
    Watchdog false alarm: conn_mgr task is not created when no WiFi credentials
    are configured (SIM-only devices). h_conn_mgr stays NULL, HWM reports 0,
    triggering the <128 warning. Guard all handle-based warnings with != NULL
    check so the warning only fires for tasks that actually exist.
    [task_mqtt_sim.h, task_watchdog.h]
2026-06-11 fix: flush stale publish queue items on SIM MQTT reconnect
    When MQTT is disconnected (SMCONN failing), task_aggregator keeps pushing
    HB_TYPED frames to publish_queue (64 slots). Queue fills in ~8 min with
    4 sensors at 30s HB interval. On reconnect, sending 64 stale heartbeats
    to the broker is wasteful and delays fresh data. Flush the queue on
    successful reconnect and log how many items were dropped.
    [task_mqtt_sim.h]
2026-06-11 fix: add limit to /data/history endpoint (default 2000, max 5000)
    Unbounded .find() on SensorReading could return tens of thousands of
    documents for long time ranges, causing large JSON responses that drop
    HTTP/2 connections through Cloudflare Tunnel.
2026-06-11 feat: add CompareChartModal for cross-controller scale synchronization
    Add Compare button on dashboard when 2+ controllers share a HumTemp port.
    Opens CompareChartModal showing all controllers on the same chart with a
    shared Y-axis (global min/max across all controllers) and same X-axis time
    range — addresses boss request to match scales for proper graph comparison.
2026-06-11 fix: prevent CompareChartModal blinking from unstable ctrlIds reference
    Replace ctrlIds array dependency with ctrlIds.join(',') string key so the
    fetch effect only re-runs when controller list actually changes, not on
    every parent re-render (App.jsx re-renders every second due to now timer).
2026-06-12 fix: include ftype=0x05 in history query, prevent flush of fresh sensor data
    Backend: add FTYPE_HB_TYPED (0x05) to ftype filter in history endpoint.
    All sensor data from this device is published as ftype=0x05 — excluding it
    meant data was saved to MongoDB but never appeared in charts or dashboard.
    Firmware: replace unconditional queue flush on reconnect with a threshold
    check (>= 48/64 slots). Brief disconnects (signal blips) no longer drop
    fresh sensor readings; full flush only triggers when queue is nearly full
    indicating a truly long offline period.
    [task_mqtt_sim.h]
2026-06-12 fix: smoother bezier curve for 7-day Compare chart
    Increase Chart.js tension from 0.25 to 0.4 when displaying 7-day range
    so the line between sparse data points (30-min interval) looks rounded
    instead of angular, matching boss feedback.
2026-06-19 fix: bootstrap soracom.io APN on first boot if not configured
    [main_module_sim7080g.ino]
2026-06-19 fix: use esp_read_mac() for device ID generation before WiFi init
    WiFi.macAddress() returns 00:00:00:00:00:00 when called before
    WiFi.mode() — causes device ID to be MM-000000 after full flash erase.
    esp_read_mac(ESP_MAC_WIFI_STA) reads eFuse directly, no WiFi needed.
    [main_module_sim7080g.ino]
2026-06-19 fix: move WiFi.mode(STA) before device ID generation to fix MAC read
    WiFi.macAddress() returns 00:00:00:00:00:00 before WiFi is initialized.
    Moving WiFi.mode(WIFI_STA) before the device_id generation ensures
    MAC is readable, producing correct ID (MM-AABBCC) on first boot after
    full flash erase. esp_now_init() still called after WIFI_STA is set.
    [main_module_sim7080g.ino]
2026-06-19 fix: use esp_read_mac(<esp_mac.h>) to read MAC before WiFi init
    WiFi.macAddress() requires WiFi stack running — returns 00:00:00 before
    WiFi.mode() is called. esp_read_mac(ESP_MAC_WIFI_STA) reads from eFuse
    directly, no WiFi needed. Correct header is <esp_mac.h>, not <esp_wifi.h>.
    [main_module_sim7080g.ino]
2026-06-19 fix: drop frames and clean nodes with null/zero sensor_type
    Backend was silently creating ghost SensorNode entries when a frame
    arrived with sensor_type=0 (e.g. controller-level ESP-NOW HELLO
    forwarded with wrong type). Now guards match the existing ctrl_id=0
    check. Startup cleanup deletes any pre-existing null/zero sensor_type
    nodes from the database.
2026-06-22 fix: cleanup SensorNodes with null port_num on backend startup
    Ghost nodes with port_num=null were created from early firmware flashes
    and survived the previous cleanup (which only covered null ctrl_id and
    null sensor_type). Added a third deleteMany pass for port_num=null.
2026-06-26 fix: remove bare box-drawing separator in task_espnow_rx.h (compile error)
    [task_espnow_rx.h]
2026-06-30 fix some errors in main module and frontend
    [main_module_sim7080g.ino, sensor_controller.ino, system_state.h]
2026-07-02 add jetson program
2026-07-02 add jetson_backup: serial backup reader for main module sensor data
    - Python script reads [RX] sensor data from ESP32-S3 via USB serial
    - Parses ctrl, port, sensor type, value from serial output
    - Stores to SQLite with UTC timestamp from Jetson clock
    - Auto-detects serial port, auto-reconnects on disconnect
    - Includes README with setup, systemd service, and SQL query examples
2026-07-06 fix: history API returns most recent data + table date display fix
    - Backend: sort history query descending + reverse to guarantee
    recent data is included within the 2000 point limit (fixes 7d
    chart showing stale June 29 data instead of current July data)
    - Frontend: table date column now uses selected range (hours >= 24)
    instead of comparing first/last data timestamps, fixing inconsistent
    date display between 24h and 7d views
2026-07-06 fix: MQTT connected flag not set on connect + WDT API update
    - task_mqtt_sim.h: Add state_set_connected(true) after successful MQTT
    connect (was only set on server HB, causing connected=no indefinitely)
    - task_mqtt_sim.h: Add state_set_connected(false) + clear server_hb_ms
    in _smq_disconnect() and publish failure path
    - task_publish.h: Add state_set_connected(true) on MQTT_EVENT_CONNECTED
    (same fix for WiFi mode)
    - main_module_sim7080g.ino: Update esp_task_wdt_init() call for ESP32
    core v3.x (struct-based API instead of positional args)
    Root cause: state_is_connected() never returned true because
    state_set_connected(true) was only called when server heartbeat
    was received, not on br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
2026-07-06 fix: WDT init compatible with ESP32 core v2.x and v3.x
    Use #if ESP_ARDUINO_VERSION_MAJOR >= 3 to select between
    struct-based API (v3.x) and positional args API (v2.x).
2026-07-06 fix: heap corruption + WDT timeout for portal mode
    Root cause analysis of persistent WDT crash (CPU 0: oled):
    - Task names corrupted with SVG HTML fragments from _signal_svg() — heap corruption
    - _signal_svg() created ~20 temp String objects per call via concatenation
    (String(x) + String(y) + ...) causing severe heap fragmentation
    - build_scan_html_from_results() created even more temp Strings per network
    - handleClient() blocks oled task for 15+ seconds on slow AP connections
    Fixes:
    1. WDT timeout: 15s → 30s (TWDT_TIMEOUT_MS define) — portal needs headroom
    2. STACK_OLED: 8192 → 16384 — more stack for String operations + WebServer
    3. _signal_svg(): Rewritten to use single snprin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
2026-08-13 Add LoRa GPS receiver pipeline to main module, fix concurrent SIM+LoRa watchdog issues
    - task_lora.h: new task receiving GPS packets via E220 LoRa module (Serial2,
    GPIO6/7), writes into dedicated GPS ring buffer
    - ring_buffer.h: add separate GpsPacket ring buffer (rb_gps) alongside the
    existing SensorPacket buffer
    - task_aggregator.h: drain rb_gps and publish GPS readings to
    ciren/gps/{device_id} via the shared publish_queue
    - system_state.h: add topic_gps, build it in state_build_topics()
    - ciren_config.h: add UART_RX_LORA/UART_TX_LORA pin defines
    - task_sim_manager.h: move modem AT bus from Serial2 to Serial1 to free
    Serial2 for the LoRa module
    - task_watchdog.h: add staleness-base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
2026-10-29 Add store-and-forward buffering, SHT45 sensor node, backend event-time fix
    - main_module_sim7080g: LittleFS-backed store-and-forward (task_flash_store.h)
    so sensor readings survive publish_queue overflow during signal outages;
    replayed records are confirmed-deleted only after a successful publish,
    never just on enqueue. Compiled successfully.
    - sensor_node/node_sht45: new SHT45 temp+humidity node, drop-in alternative
    to node_dht20 (reuses STYPE_TEMPERATURE/STYPE_HUMIDITY). Compiled successfully.
    - backend: Log TTL extended 7->30 days; sensor_data ingestion now prefers the
    device's NTP-synced timestamp over arrival time for server_ts/eventMs, so
    backfilled/replayed readings land a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
2026-10-30 Rework sensor data pipeline as write-ahead flash ledger, restore prod .config
    - task_aggregator.h: every DATA/DATA_TYPED reading is now written to the
    flash ledger (task_flash_store.h) immediately on receipt, before it ever
    touches publish_queue. publish_queue is fed exclusively from the flash
    backlog (_agg_replay_from_flash), looped per tick so a burst larger than
    AGG_PUB_BATCH still drains within the same ~10ms tick. This closes the
    RAM-only window that previously existed for live (non-overflow) readings
    between being received and successfully published — a crash/reboot/power
    loss at any point after a reading is received can no longer lose it,
    except for the brief window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
